Plokkke/viessmann-optolink-esphome/knowledge/photos/boiler-terminals.jpg

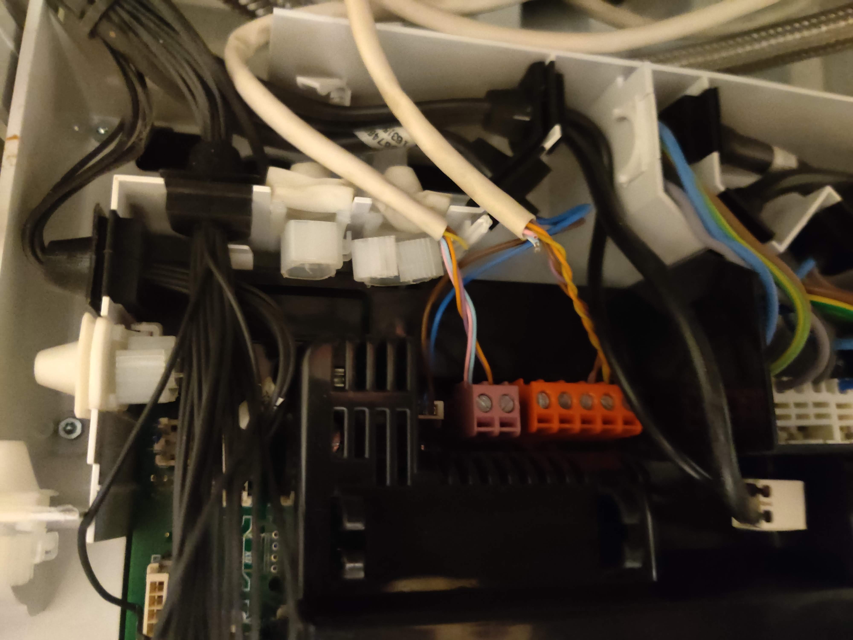
knowledge/photos/boiler-terminals.jpg
