Plokkke/viessmann-optolink-esphome/knowledge/photos/breadboard-prototype.jpg

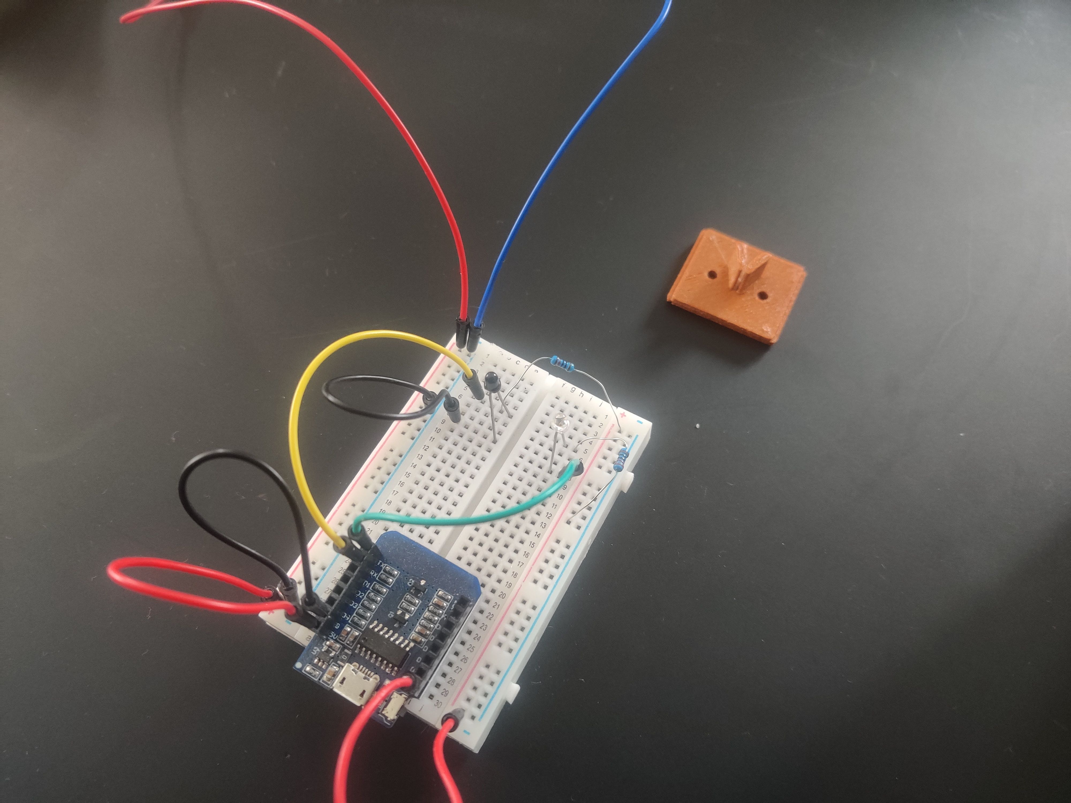
knowledge/photos/breadboard-prototype.jpg
