Plokkke/viessmann-optolink-esphome/knowledge/photos/breadboard-resistors.jpg

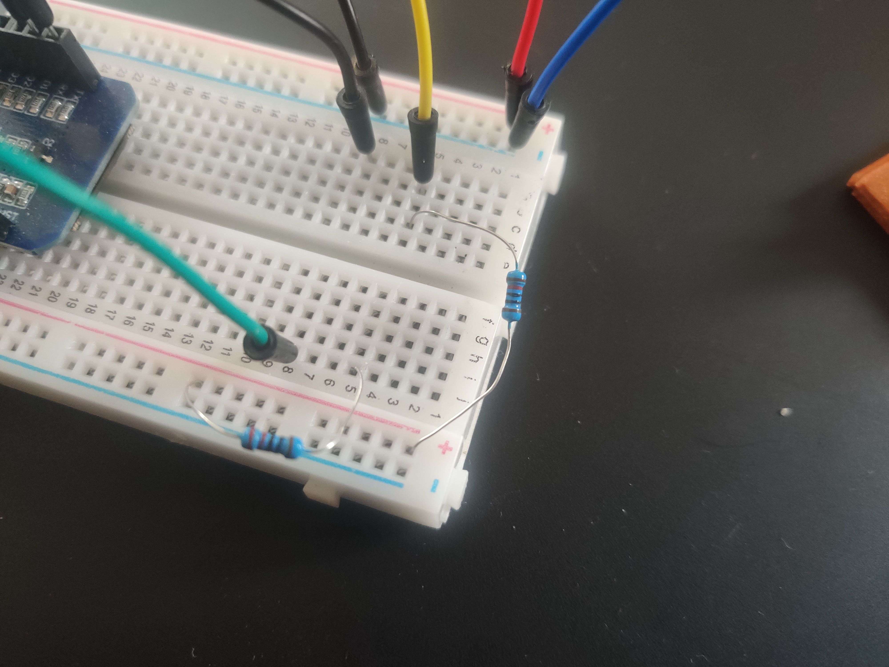
knowledge/photos/breadboard-resistors.jpg
