Plokkke/viessmann-optolink-esphome/knowledge/photos/ir-led-phototransistor.jpg

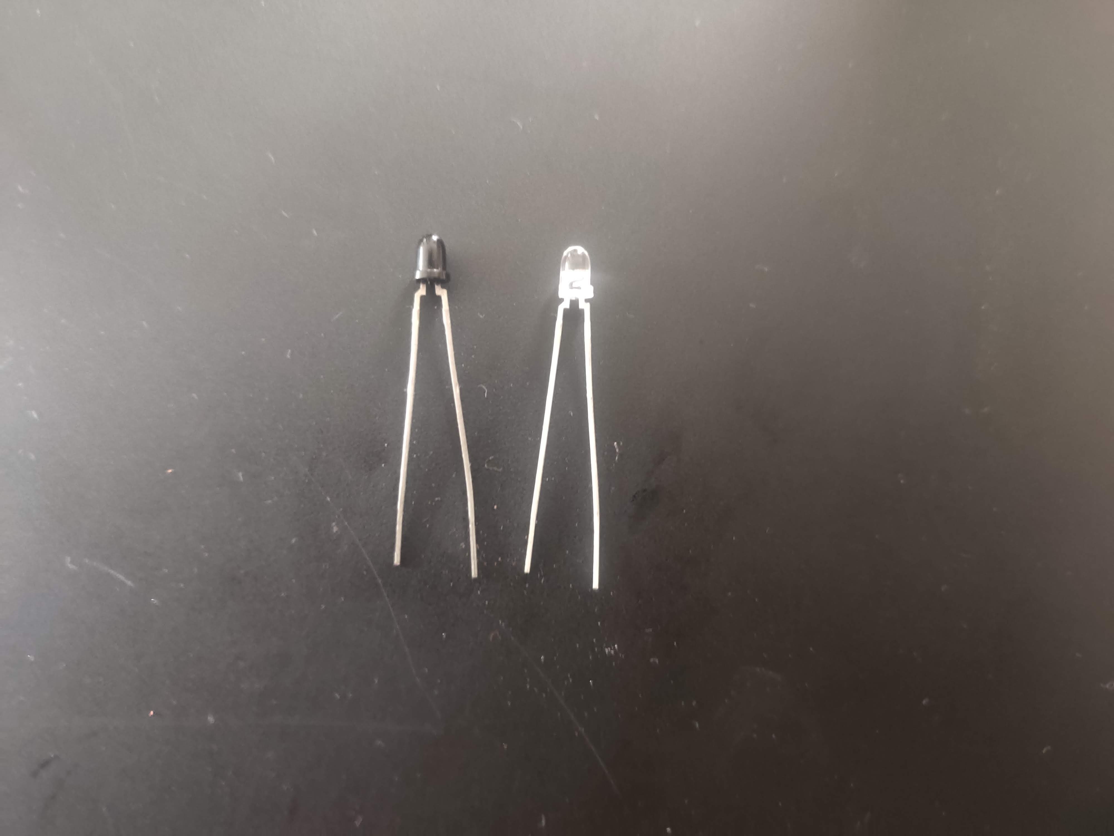
knowledge/photos/ir-led-phototransistor.jpg
