Plokkke/viessmann-optolink-esphome/enclosure/heater-enclosure-right-shell.stl

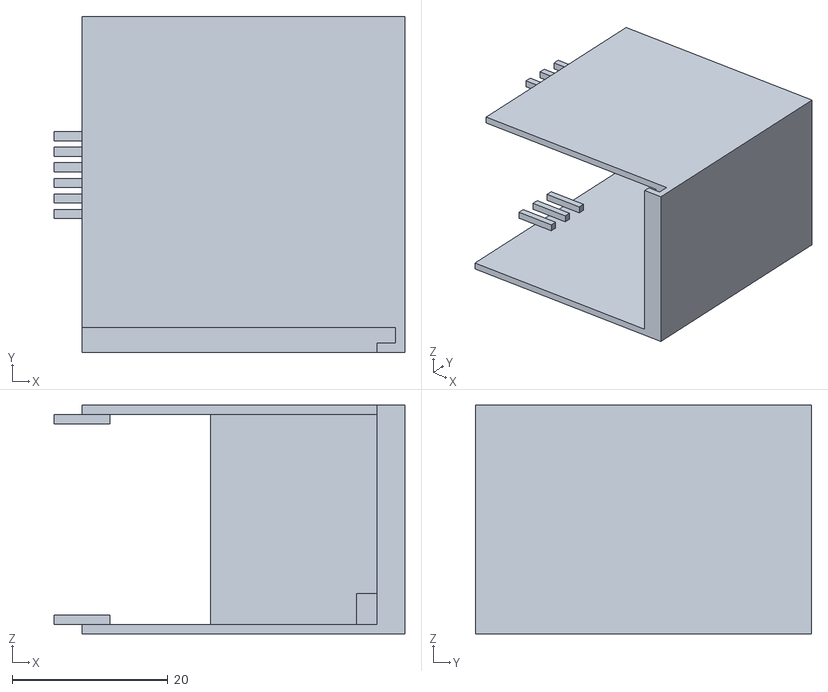
[picture p8: CAD file, 2026-11-04]
enclosure/heater-enclosure-right-shell.stl
45.1 x 43.2 x 29.4
