Plokkke/viessmann-optolink-esphome/hardware/exports/heater-controller.step

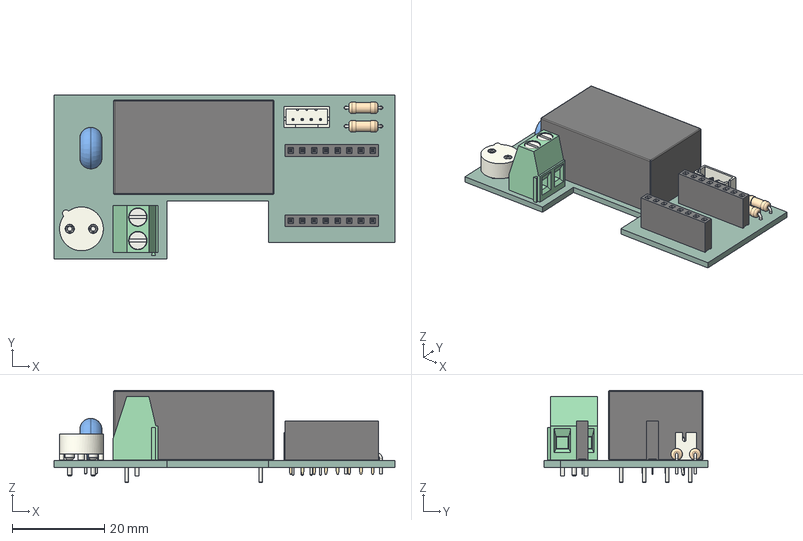
[picture p9: CAD file, 2026-11-04]
hardware/exports/heater-controller.step
74.0 x 35.5 x 20.0 mm
RV_Disc_D9mm_W48mm_P5mm
A_Littelfuse_No560_No460
JST_B4B_PH_K
TerminalBlock_Phoenix_MKDS-1,5-2-5.08_1x02_P5.08mm_Horizontal
PinSocket_1x08_P2.54mm_Vertical x 2
Converter_ACDC_Hi-Link_HLK-PMxx
R_Axial_DIN0207_L63mm_D25mm_P762mm_Horizontal x 2
heater-controller_PCB
