Plokkke/viessmann-optolink-esphome/enclosure/heater-enclosure-optical-plug.stl

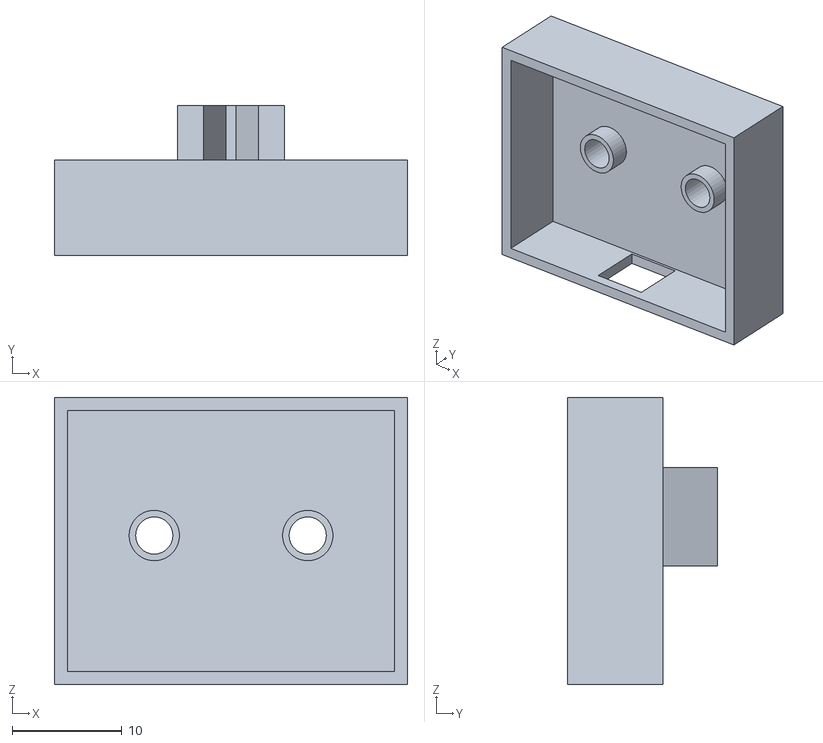
[picture p10: CAD file, 2026-11-04]
enclosure/heater-enclosure-optical-plug.stl
32.2 x 13.7 x 26.2
