Plokkke/viessmann-optolink-esphome/enclosure/print-setup.stl

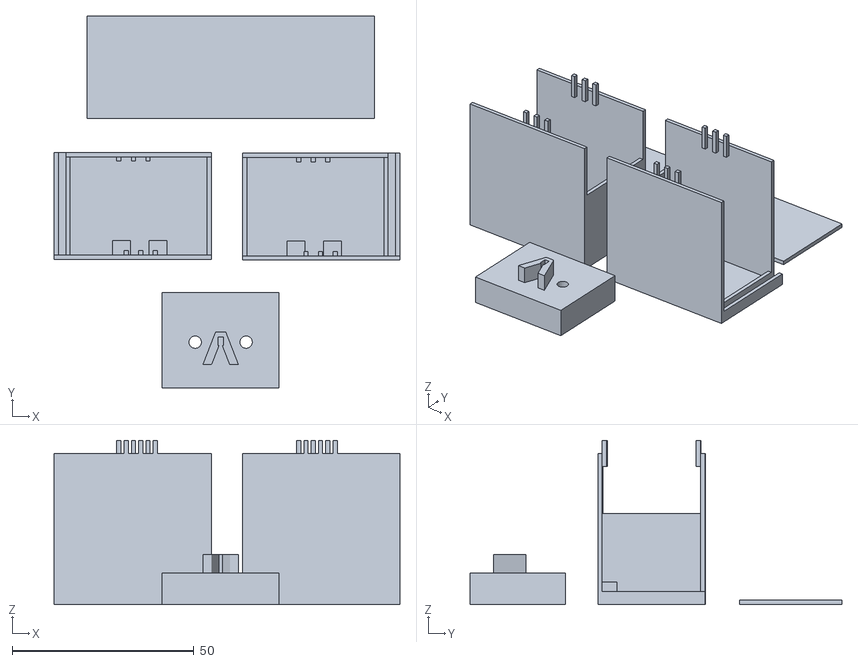
[picture p11: CAD file, 2026-11-04]
enclosure/print-setup.stl
95.0 x 102.2 x 45.1
