Plokkke/viessmann-optolink-esphome/enclosure/heater-enclosure-lid.stl

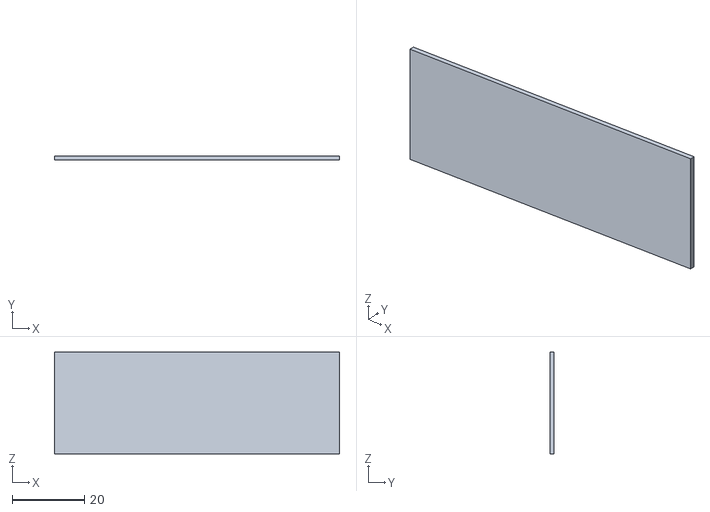
[picture p12: CAD file, 2026-11-04]
enclosure/heater-enclosure-lid.stl
79.0 x 1.20 x 28.2
