Plokkke/viessmann-optolink-esphome/(list of files, cad)

Other CAD files:
enclosure/heater-enclosure-left-shell.stl
enclosure/heater-enclosure.f3d
hardware/exports/heater-controller.stl
