Plokkke/viessmann-optolink-esphome/knowledge/photos/boiler-wiring-diagram.jpg

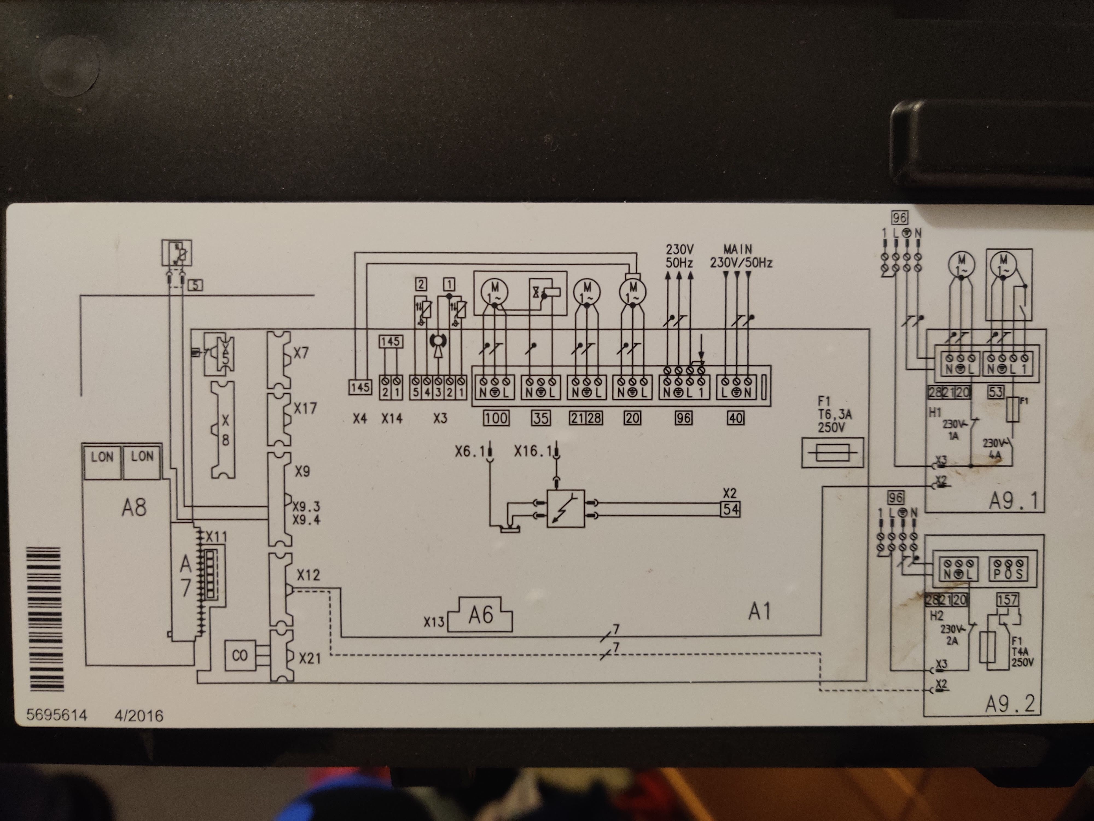
knowledge/photos/boiler-wiring-diagram.jpg
