Plokkke/viessmann-optolink-esphome/hardware/heater-controller.kicad_pcb

## KiCad design hardware/heater-controller.kicad_pcb (2026-11-04)

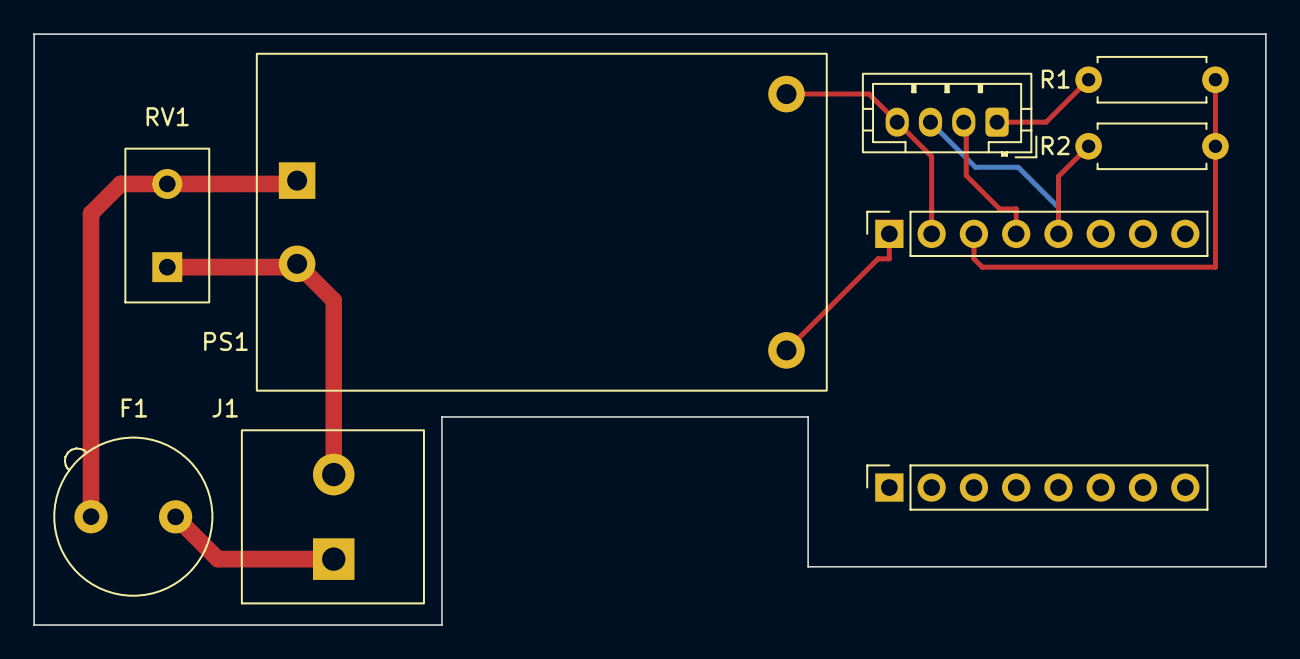
[picture p14: board heater-controller.kicad_pcb from above]

Board: 2 copper layers, 74.0 x 35.5 mm, 10 parts (0 on the bottom side), 9 nets.

Parts:
F1: TR5 holder + T1A fuse; Fuseholder_TR5_Littelfuse_No560_No460
J1: KF128-5.08 (plug 96); TerminalBlock_Kefa_KF128-5.08_1x02
J2: JST B4B-PH-K (optical head); JST_PH_B4B-PH-K_1x04_P2.00mm_Vertical_Drill0.9
J3: Socket 1x8 THT (C3 pins 1-8); PinSocket_1x08_P2.54mm_Vertical
J4: Socket 1x8 THT (C3 pins 9-16); PinSocket_1x08_P2.54mm_Vertical
MOD1: ESP32-C3_SuperMini; ESP32-C3_SuperMini_Outline
PS1: HLK-PM01; Converter_ACDC_HLK-PM01
R1: 220; R_Axial_DIN0207_L6.3mm_D2.5mm_P7.62mm_Horizontal
R2: 10k; R_Axial_DIN0207_L6.3mm_D2.5mm_P7.62mm_Horizontal
RV1: MOV-07D431K (275VAC); RV_Disc_D9mm_W4.8mm_P5mm_Inline

Connections:
+5V: J3.1, PS1.4
/3V3: J3.3, R1.1, R2.1
/L: F1.1, J1.1
/LED_A: J2.1, R1.2
/L_FUSED: F1.2, PS1.1, RV1.2
/N: J1.2, PS1.2, RV1.1
/RX_GPIO3: J2.3, J3.5, R2.2
/TX_GPIO4: J2.2, J3.4
GND: J2.4, J3.2, PS1.3
