Plokkke/viessmann-optolink-esphome/(commit log)

2026-10-26 chore: ignore ESPHome secrets and KiCad local files
2026-10-26 docs(knowledge): document Optolink datapoints and boiler setup
    - architecture and safety notes, Vitodens 222-W / Vitotronic 200 HO1B
    datapoints, heating circuit pressure notes
    - Viessmann manuals, optolink component doc and prototype photos
    (EXIF metadata stripped)
2026-10-26 feat(firmware): add ESPHome Optolink controller
    Read and write Vitotronic datapoints (boiler temperature, room setpoint,
    operating and economy modes, fault) over the P300 protocol, plus a
    connectivity test firmware with fake entities.
2026-10-26 feat(enclosure): add 3D-printed Optolink adapter enclosure
    [heater-controller.3mf, heater-controller.stl]
2026-10-26 feat(hardware): add dedicated KiCad board with mains supply
    D1 mini on SMD sockets on top, IR LED and phototransistor on the bottom
    at the 14 mm Optolink plate spacing, on-board HLK-PM01 with fuse and
    varistor, isolation slot and clearance DRC rules, STEP model.
    [heater-controller.kicad_pcb, heater-controller.kicad_sch, heater-controller.step]
2026-10-26 docs: add project status, keywords and language switch to README
2026-10-27 feat(hardware): move to ESP32-C3 on a removable U-shaped board (#1)
    * feat(hardware): move to ESP32-C3 on a removable U-shaped board
    - ESP32-C3 super mini replaces the D1 mini: Optolink UART on GPIO4/GPIO3,
    logs over native USB
    - inverted U board (86 x 39.5 mm): 230 V leg, optical head header on the bar,
    C3 on SMD female sockets; screw terminal for the mains wires
    - off-board optical head on a 4-wire ribbon
    - back GND pour, 0.7 mm power tracks, 6 mm mains isolation checked by DRC
    - C3 socket footprint generator and fabrication export script
    - enclosure redrawn around the new board
    * feat(hardware): hand-solderable board with SMD C3 sockets for JLCPCB
    - C3 plugged into two hanxia 1x8 S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
    [heater-controller.3mf, heater-controller.kicad_pcb, heater-controller.kicad_sch, heater-controller.step, heater-controller.stl, heater-enclosure-left-shell.stl, heater-enclosure-lid.stl, heater-enclosure-optical-plug.stl]
2026-11-04 feat(hardware): flat through-hole board, enclosure v15 and order files (#2)
    The board now lies flat, perpendicular to the boiler front, in a wider
    enclosure, and every part is through-hole. The same board can be
    hand-soldered (bare board from JLCPCB, parts from LCSC) or fully
    assembled by JLCPCB without a separate LCSC order.
    - smaller inverted U board (74 x 35.5 mm), HLK lying on the bar, C3
    outline realigned on its sockets so the antenna keepout is right
    - J1 turned over so the 230 V wires enter from the notch; terminal 1
    is L, terminal 2 is N
    - J3/J4 become 1x8 THT sockets (LCSC C27438); RX runs on the back,
    R1/R2 get LCSC numbers; DRC with no error or warning
    - schematic redrawn i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
    [heater-controller.kicad_pcb, heater-controller.kicad_sch, heater-controller.step, heater-controller.stl, heater-enclosure-left-shell.stl, heater-enclosure-lid.stl, heater-enclosure-optical-plug.stl, heater-enclosure-right-shell.stl]
2026-11-05 feat(firmware): switch to esphome_vitohome and rewrite the README (#3)
    The ESPHome optolink component (esphome#4453) was closed unmerged by
    its author and is no longer maintained. The firmware now uses
    esphome_vitohome, a maintained ESPHome component that speaks the same
    P300 protocol and was developed on the same controller (HO1B, 20CB).
    The README is rewritten for people who want to use the project.
    - firmware: esphome_vitohome pinned to v0.6, explicit 4800 8E2 UART on
    GPIO4/GPIO3, same entity names and verified addresses
    - new Heating climate entity: room setpoint and operating mode as
    presets (written at 0x2323, read back at 0x2301); it replaces the
    Room Temperature Setpoint numbe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
    [controlleur-chaudiere.yaml]
